MateoHadzimustafic/Voltage-Controlled-Oscillator/images/3D_view.png

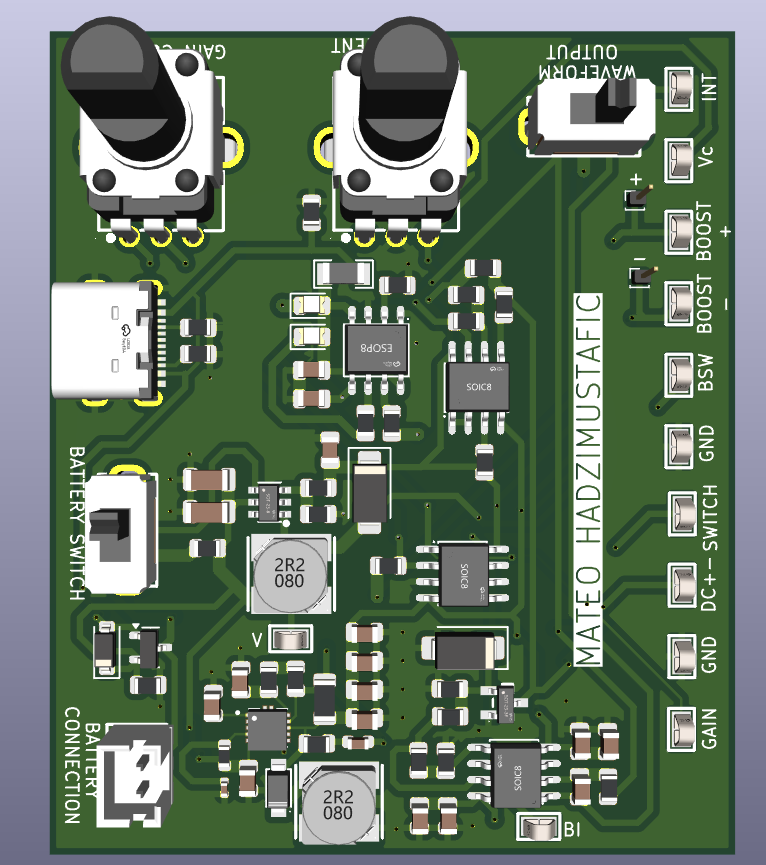
images/3D_view.png
