MateoHadzimustafic/Voltage-Controlled-Oscillator/images/VCO.jpg

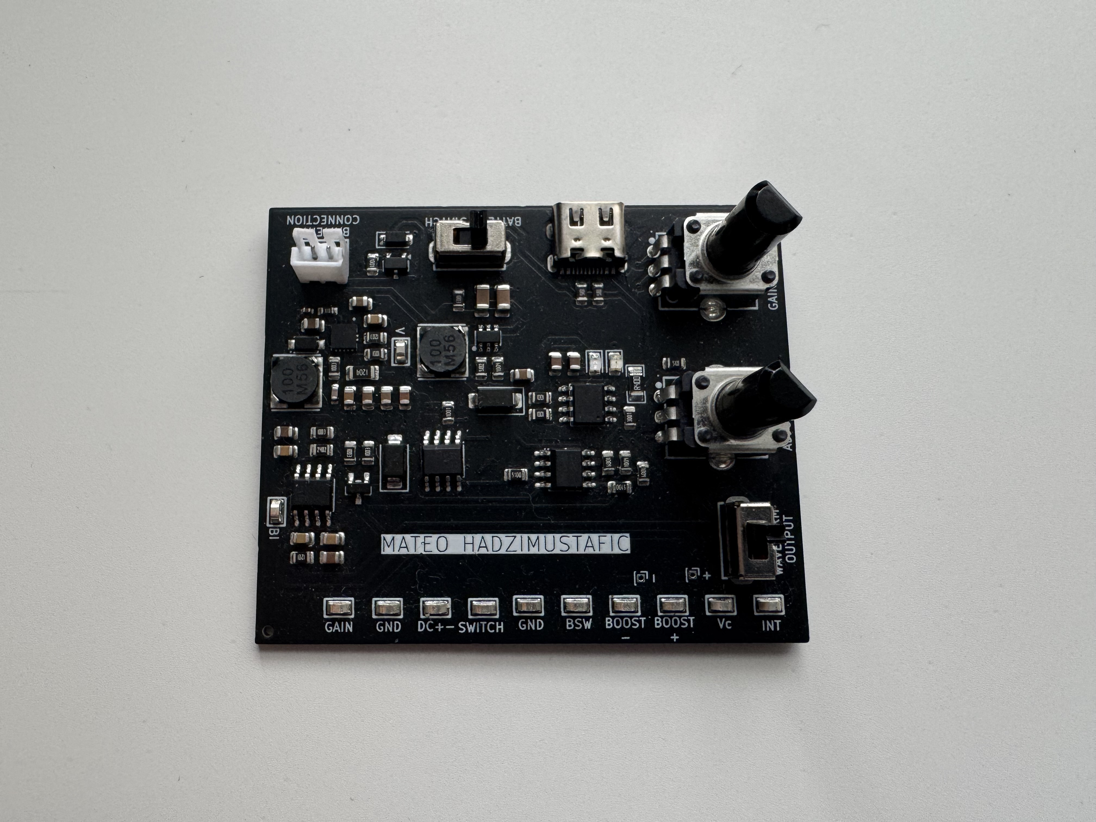
images/VCO.jpg
