MateoHadzimustafic/Voltage-Controlled-Oscillator/README.md

# Voltage-Controlled-Oscillator

## Overview

Designed and built a Voltage-Controlled Oscillator (VCO) capable of generating square and triangle waveforms with adjustable frequency and amplitude using op-amp-based analog circuitry. Integrated USB power management and LiPo battery input for portable or wired operation, including onboard LiPo charging functionality for convenient rechargeable power support.

## Current Status

Completed — Fully designed, built, tested, and validated.

## Features

- Square Wave Generator
- Triangle Wave Generator
- Frequency Control
- Amplitude Control
- Lipo Battery and USB-C Powered
- Lipo Battery Charger

## Repository Structure

- `docs/` — design notes, calculations, and planning
- `hardware/` — schematic, PCB layout, and manufacturing files
- `bom/` — bill of materials and component notes
- `images/` — renders, diagrams, and photos
