MateoHadzimustafic/Voltage-Controlled-Oscillator/images/layout.png

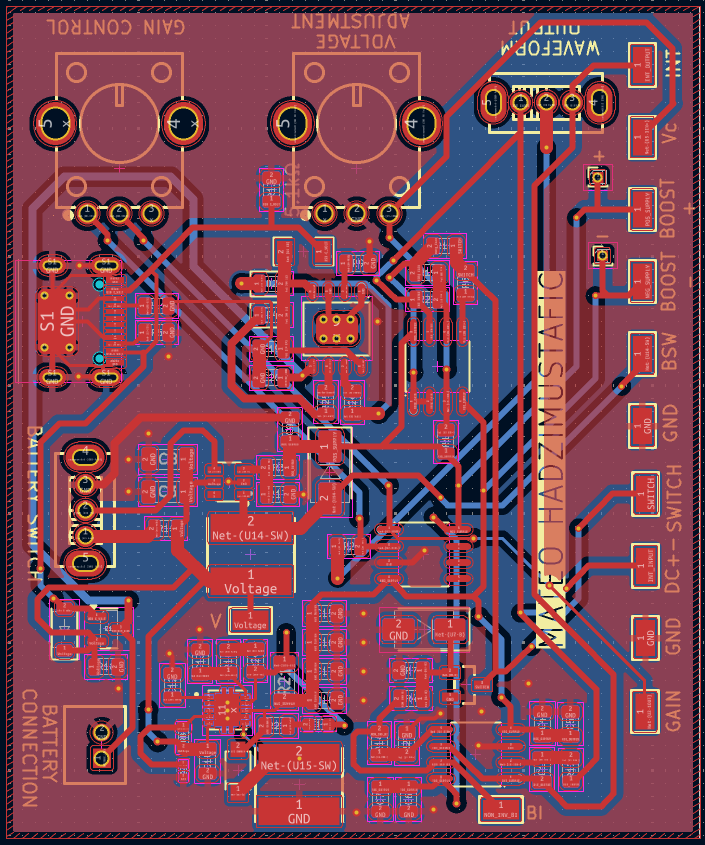
images/layout.png
