MateoHadzimustafic/Voltage-Controlled-Oscillator/images/schematic.png

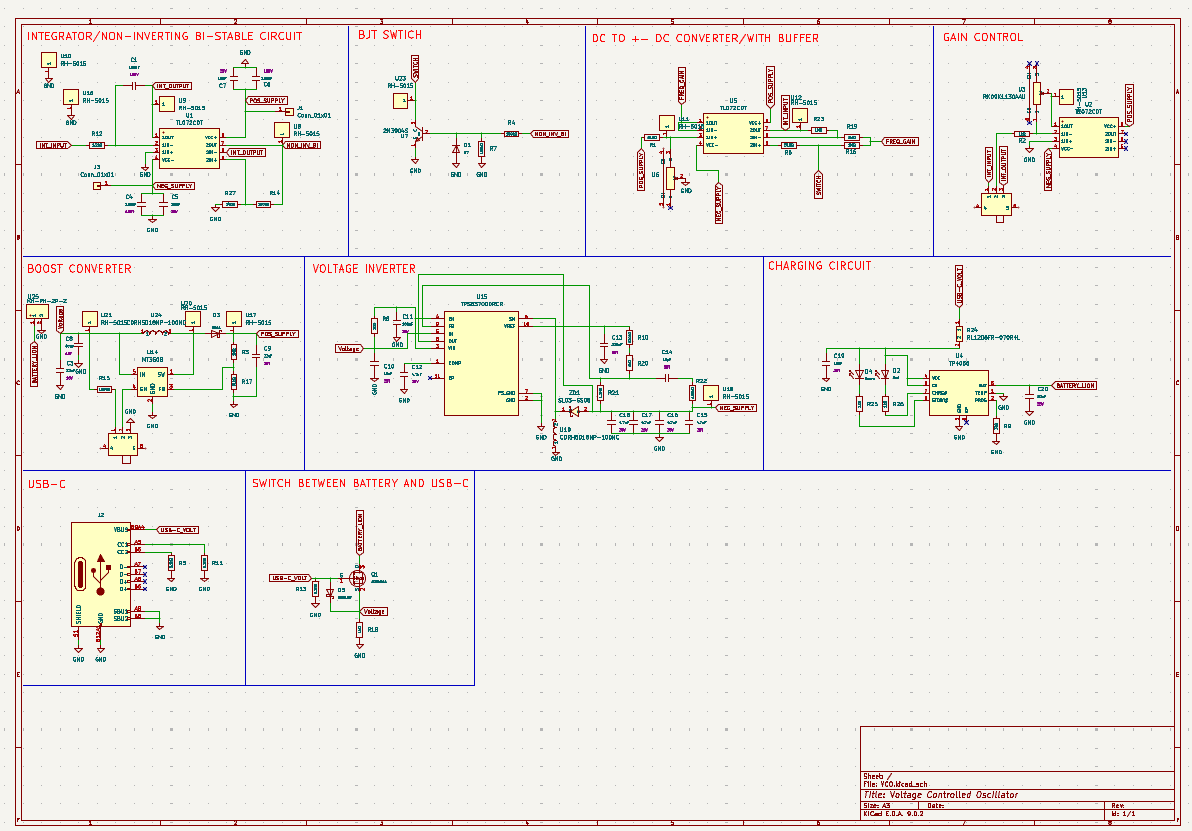
images/schematic.png
