MateoHadzimustafic/Voltage-Controlled-Oscillator/bom/bom.md

# Bill of Materials (BOM)

| Designator | Quantity | Value / Part | Footprint | LCSC Part # |
|---|---|---|---|---|
| C1, C4, C6 | 3 | 100nF | C_0805 | C28233 |
| C10, C19, C20, C5, C7 | 5 | 10uF | C_0805 | C15850 |
| C11 | 1 | 100nF | C_0402 | C1525 |
| C12, C15, C16, C17, C18 | 5 | 4.7uF | C_0805 | C1779 |
| C13 | 1 | 220nF | C_0805 | C5378 |
| C14 | 1 | 1uF | C_0603 | C1634 |
| C3 | 1 | 22uF | C_1206 | C5672 |
| C8 | 1 | 47uF | C_1206 | C96123 |
| C9 | 1 | 22uF | C_0805 | C45783 |
| D1 | 1 | M7 | D_SMA | C95872 |
| D2 | 1 | Red LED | D_0805 | C84256 |
| D3 | 1 | SS14 | D_SMA | C24865 |
| D4 | 1 | Green LED | D_0805 | C2297 |
| D5 | 1 | B5819W | D_SOD-123 | C64885 |
| J1, J3 | 2 | Conn_01x01 | PinHeader_1x01_P2.00mm_Vertical | — |
| J2 | 1 | USB Type-C 16P | TYPE-C-SMD_HX-TYPE-C-16PIN | C2927039 |
| Q1 | 1 | AO3401A | SOT-23 | C15127 |
| R1, R6 | 2 | 510Ω | R_0805 | C17734 |
| R10 | 1 | 120kΩ | R_0805 | C17436 |
| R11, R13, R5 | 3 | 5.1kΩ | R_0805 | C27834 |
| R12 | 1 | 1.2kΩ | R_0805 | C17379 |
| R14, R15, R22, R4, R7 | 5 | 100kΩ | R_0805 | C149504 |
| R16, R19, R23, R3 | 4 | 1MΩ | R_0805 | C17514 |
| R17 | 1 | 510Ω | R_0805 | C17737 |
| R18, R2, R20, R25, R26 | 5 | 1kΩ | R_0805 | C17513 |
| R21 | 1 | 1.2MΩ | R_1206 | C22107 |
| R24 | 1 | RL1206FR-070R4L | R1206 | C32078 |
| R27 | 1 | 24kΩ | R_0805 | C17575 |
| R8 | 1 | 10Ω | R_0603 | C22859 |
| R9 | 1 | 3kΩ | R_0805 | C17661 |
| SW1, SW2 | 2 | SS12D07VG6 | SW-TH_SS12D07VG4 | C393728 |
| U1, U2, U5 | 3 | TL072CDT | SOIC-8_L5.0-W4.0-P1.27-LS6.0-BL | C6961 |
| U10, U11, U12, U13, U16, U17, U18, U20, U21, U23, U8 | 12 | BH-5015 | SMD_BH-5015 | C5199798 |
| U14 | 1 | MT3608 | SOT-23-6 | C84817 |
| U15 | 1 | TPS63700DRCR | VREG_VQFN-10 | C54792 |
| U19, U24 | 2 | CDRH5D18NP-100NC | IND-SMD_L5.7-W5.7 | C113636 |
| U25 | 1 | KH-PH-2P-Z | CONN-TH_LKP-H2 | C2898945 |
| U3, U6 | 2 | RK09K1130AU | RES-TH_RK09K1130AU | C202373 |
| U4 | 1 | TP4056 | ESOP-8 | C16581 |
| U7 | 1 | 2N3904S | SOT-23 | C18536 |
| ZD1 | 1 | SL03-GS08 | SMF_L2.8-W1.8-LS3.7-RD | C490381 |
