MateoHadzimustafic/Voltage-Controlled-Oscillator/(list of files, drawings)

Other design files:
docs/Design1.ms14
