MateoHadzimustafic/Voltage-Controlled-Oscillator/hardware/VCO.kicad_pcb

## KiCad design hardware/VCO.kicad_pcb (2026-04-28)

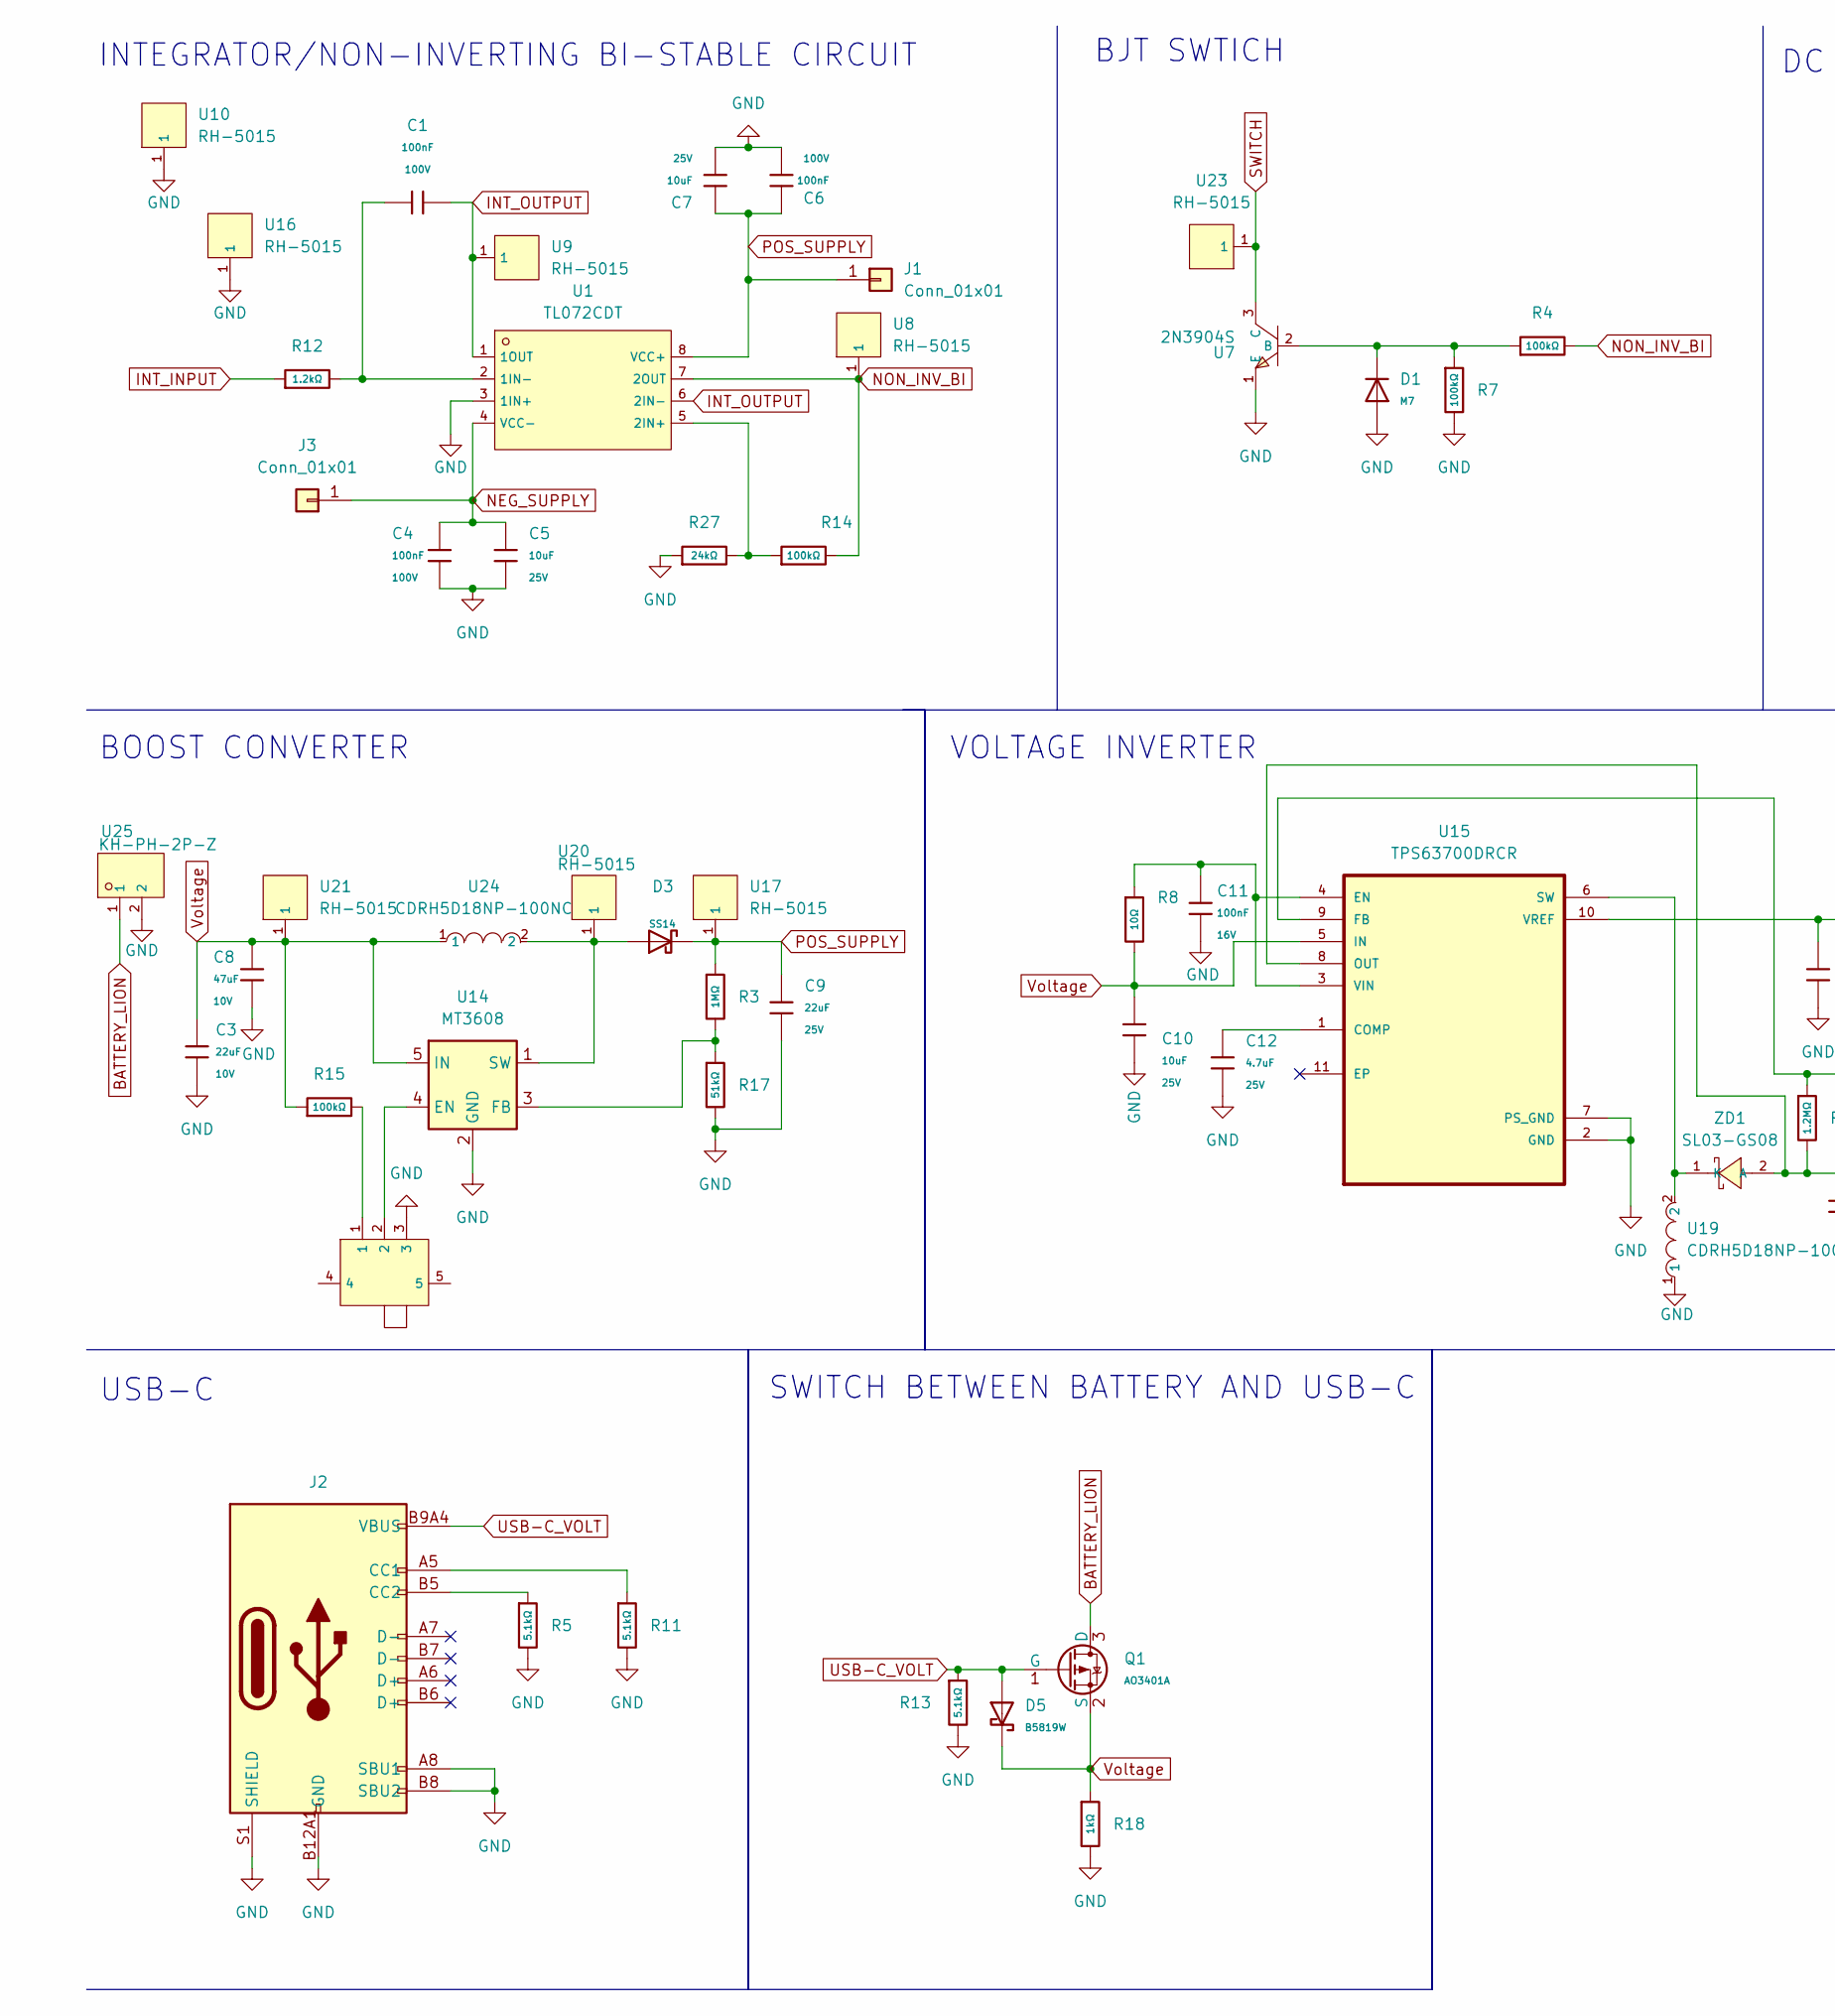
[picture p5: schematic VCO.kicad_sch, Voltage Controlled Oscillator, part in row 1, column 1]

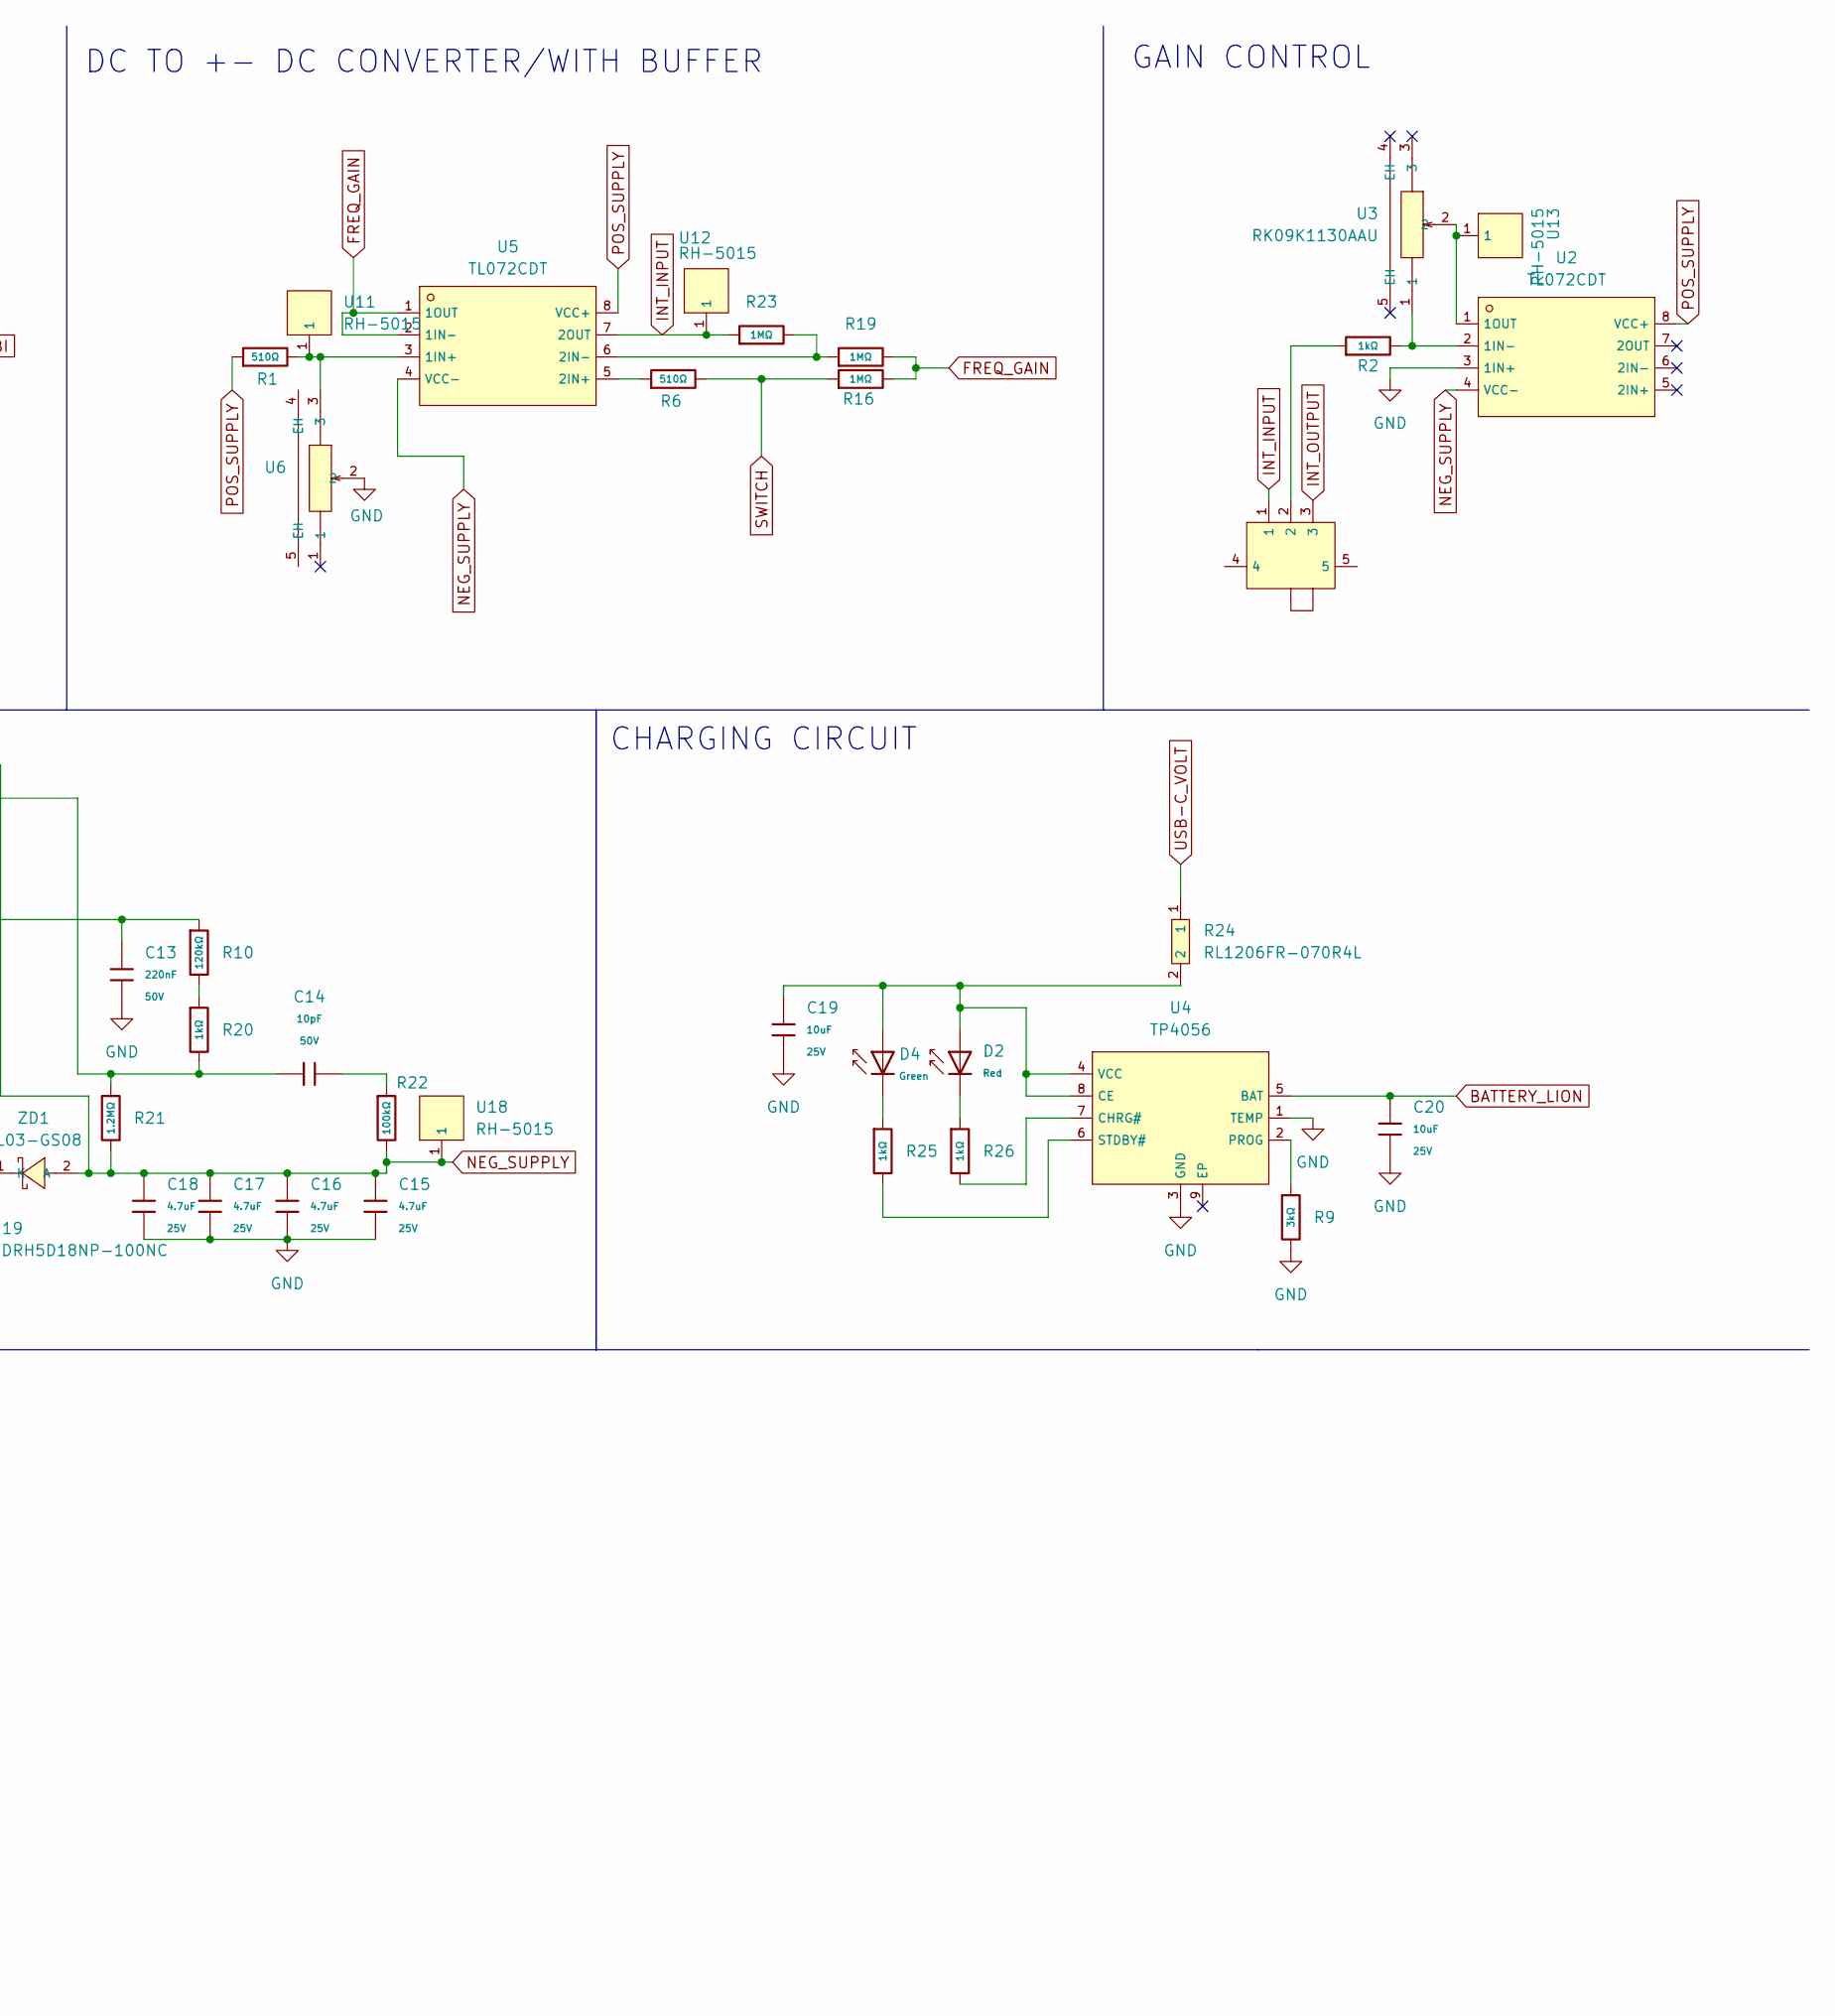
[picture p6: schematic VCO.kicad_sch, Voltage Controlled Oscillator, part in row 1, column 2]

Parts:
C1, C4, C6: 100nF; C_0805; Voltage Rated 100V; Tolerance ±10%; Part CL21B104KCFNNNE; LCSC C28233
C3: 22uF; C_1206; Voltage Rated 10V; Tolerance ±10%; Part CL31A226KPHNNNE; LCSC C5672
C5, C7, C10, C19, C20: 10uF; C_0805; Voltage Rated 25V; Tolerance ±10%; Part CL21A106KAYNNNE; LCSC C15850
C8: 47uF; C_1206; Voltage Rated 10V; Tolerance ±20%; Part CL31A476MPHNNNE; LCSC C96123
C9: 22uF; C_0805; Voltage Rated 25V; Tolerance ±20%; Part CL21A226MAQNNNE; LCSC C45783
C11: 100nF; C_0402; Voltage Rated 16V; Tolerance ±10%; Part CL05B104KO5NNNC; LCSC C1525
C12, C15, C16, C17, C18: 4.7uF; C_0805; Voltage Rated 25V; Tolerance ±10%; Part CL21A475KAQNNNE; LCSC C1779
C13: 220nF; C_0805; Voltage Rated 50V; Tolerance ±10%; Part CL21B224KBFNNNE; LCSC C5378
C14: 10pF; C_0603; Voltage Rated 50V; Tolerance ±5%; Part CL10C100JB8NNNC; LCSC C1634
D1: M7; D_SMA; Forward Voltage (Vf@If) 1.1V@1A; Reverse Voltage (Vr) 1kV; Part M7; LCSC C95872
D2: Red; D_0805; Forward Voltage (VF) 1.6V~2.6V; Part NCD0805R1; LCSC C84256
D3: SS14; D_SMA; Forward Voltage (Vf@If) 0.55V@1.0A; Reverse Voltage (Vr) 40V; Part SS14; LCSC C7420316
D4: Green; D_0805; Part KT-0805G; LCSC C2297
D5: B5819W; D_SOD-123; Forward Voltage (Vf@If) 900mV@3A; Reverse Voltage (Vr) 40V; Part B5819W; LCSC C64885
J1, J3: Conn_01x01; PinHeader_1x01_P1.00mm_Vertical
J2: Connector, USB-TYPE-C-16P; TYPE-C-SMD_HX-TYPE-C-16PIN; LCSC C2927039
Q1: AO3401A; Q_SOT-23; Part AO3401A; LCSC C15127
R1, R6: 510Ω; R_0805; Overload Voltage (Max) 150V; Tolerance ±1%; Part 0805W8F5100T5E; LCSC C17734
R2, R18, R20, R25, R26: 1kΩ; R_0805; Overload Voltage (Max) 150V; Tolerance ±1%; Part 0805W8F1001T5E; LCSC C17513
R3, R16, R19, R23: 1MΩ; R_0805; Overload Voltage (Max) 150V; Tolerance ±1%; Part 0805W8F1004T5E; LCSC C17514
R4, R7, R14, R15, R22: 100kΩ; R_0805; Overload Voltage (Max) 150V; Tolerance ±1%; Part 0805W8F1003T5E; LCSC C149504
R5, R11, R13: 5.1kΩ; R_0805; Overload Voltage (Max) 150V; Tolerance ±1%; Part 0805W8F5101T5E; LCSC C27834
R8: 10Ω; R_0603; Overload Voltage (Max) 75V; Tolerance ±1%; Part 0603WAF100JT5E; LCSC C22859
R9: 3kΩ; R_0805; Overload Voltage (Max) 150V; Tolerance ±1%; Part 0805W8F3001T5E; LCSC C17661
R10: 120kΩ; R_0805; Overload Voltage (Max) 150V; Tolerance ±1%; Part 0805W8F1203T5E; LCSC C17436
R12: 1.2kΩ; R_0805; Overload Voltage (Max) 150V; Tolerance ±1%; Part 0805W8F1201T5E; LCSC C17379
R17: 51kΩ; R_0805; Overload Voltage (Max) 150V; Tolerance ±1%; Part 0805W8F5102T5E; LCSC C17737
R21: 1.2MΩ; R_1206; Overload Voltage (Max) 200V; Tolerance ±1%; Part 1206W4F1204T5E; LCSC C22107
R24: RL1206FR-070R4L; R1206; LCSC C327078
R27: 24kΩ; R_0805; Overload Voltage (Max) 150V; Tolerance ±1%; Part 0805W8F2402T5E; LCSC C17575
SW1, SW2: SS12D07VG6_087; SW-TH_SS12D07VG4; LCSC C2939728
U1, U2, U5: TL072CDT; SOIC-8_L5.0-W4.0-P1.27-LS6.0-BL; Voltage - Input Offset(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 3mV; Part TL072CDT; LCSC C6961
U3, U6: RK09K1130AAU; RES-TH_RK09K1130AAU; LCSC C202373
U4: TP4056; ESOP-8_L4.9-W3.9-P1.27-LS6.0-BL-EP; Part TP4056-42-ESOP8; LCSC C16581
U7: 2N3904S; SOT-23-3_L2.9-W1.3-P1.90-LS2.4-TR; LCSC C18536
U8, U9, U10, U11, U12, U13, U16, U17, U18, U20, U21, U23: RH-5015; SMD_RH-5015; LCSC C5199798
U14: MT3608; SOT-23-6_L2.9-W1.6-P0.95-LS2.8-BL; LCSC C84817
U15: TPS63700DRCR; VREG_V62_16624-01YE; LCSC C54792
U19, U24: CDRH5D18NP-100NC; IND-SMD_L5.7-W5.7_CDRH5D18NP; LCSC C113636
U25: KH-PH-2P-Z; CONN-TH_2P-P2.00_KINGHELM_KH-PH-2P-Z; LCSC C2898945
ZD1: SL03-GS08; SMF_L2.8-W1.8-LS3.7-RD; LCSC C490381

Connections:
BATTERY_LION: C20.1, Q1.3 (D), U4.5 (BAT), U25.1
FREQ_GAIN: R16.2, R19.2, U5.1 (1OUT), U5.2 (1IN-)
GND: C3.2, C4.2, C5.2, C6.2, C7.2, C8.2, C9.2, C10.2, C11.2, C12.2, C13.2, C15.2, C16.2, C17.2, C18.2, C19.2, C20.2, D1.2, J2.A8 (SBU1), J2.A12B1 (GND), J2.B8 (SBU2), J2.B12A1 (GND), J2.S1 (SHIELD), R5.2, R7.2, R9.2, R11.2, R13.2, R17.2, R18.2, R27.1, SW1.3, U1.3 (1IN+), U2.3 (1IN+), U4.1 (TEMP), U4.3 (GND), U6.2, U7.1 (E), U10.1, U14.2 (GND), U15.2 (GND), U15.7 (PS_GND), U16.1, U19.1, U25.2
INT_INPUT: R12.1, R23.1, SW2.1, U5.7 (2OUT), U12.1
INT_OUTPUT: C1.2, SW2.3, U1.1 (1OUT), U1.6 (2IN-), U9.1
NEG_SUPPLY: C4.1, C5.1, C15.1, C16.1, C17.1, C18.1, J3.1, R21.2, R22.2, U1.4 (VCC-), U2.4 (VCC-), U5.4 (VCC-), U15.8 (OUT), U18.1, ZD1.2 (A)
NON_INV_BI: R4.2, R14.2, U1.7 (2OUT), U8.1
unnamed: C14.2, R22.1
unnamed: D2.1, R26.1
unnamed: D4.1, R25.1
unnamed: J2.A5 (CC1), R11.1
unnamed: J2.B5 (CC2), R5.1
unnamed: R2.1, SW2.2
unnamed: R10.2, R20.1
unnamed: R15.2, SW1.1
unnamed: C1.1, R12.2, U1.2 (1IN-)
unnamed: R14.1, R27.2, U1.5 (2IN+)
unnamed: R2.2, U2.2 (1IN-), U3.1
unnamed: U2.1 (1OUT), U3.2, U13.1
unnamed: C19.1, D2.2, D4.2, R24.2, U4.4 (VCC), U4.8 (CE)
unnamed: R26.2, U4.7 (CHRG#)
unnamed: R9.1, U4.2 (PROG)
unnamed: R25.2, U4.6 (STDBY#)
unnamed: R1.2, U5.3 (1IN+), U6.3, U11.1
unnamed: R6.1, U5.5 (2IN+)
unnamed: R19.1, R23.2, U5.6 (2IN-)
unnamed: D1.1, R4.1, R7.1, U7.2 (B)
unnamed: SW1.2, U14.4 (EN)
unnamed: R3.2, R17.1, U14.3 (FB)
unnamed: D3.2, U14.1 (SW), U20.1, U24.2
unnamed: C12.1, U15.1 (COMP)
unnamed: C11.1, R8.1, U15.3 (VIN), U15.4 (EN)
unnamed: C14.1, R20.2, R21.1, U15.9 (FB)
unnamed: U15.6 (SW), U19.2, ZD1.1 (K)
unnamed: C13.1, R10.1, U15.10 (VREF)
POS_SUPPLY: C6.1, C7.1, C9.1, D3.1, J1.1, R1.1, R3.1, U1.8 (VCC+), U2.8 (VCC+), U5.8 (VCC+), U17.1
SWITCH: R6.2, R16.1, U7.3 (C), U23.1
USB-C_VOLT: D5.2, J2.A9B4 (VBUS), J2.B9A4 (VBUS), Q1.1 (G), R13.1, R24.1
Voltage: C3.1, C8.1, C10.1, D5.1, Q1.2 (S), R8.2, R15.1, R18.1, U14.5 (IN), U15.5 (IN), U21.1, U24.1

Notes on the sheet:
BJT SWTICH
GAIN CONTROL
VOLTAGE INVERTER
DC TO +- DC CONVERTER/WITH BUFFER
CHARGING CIRCUIT
SWITCH BETWEEN BATTERY AND USB-C
USB-C
INTEGRATOR/NON-INVERTING BI-STABLE CIRCUIT
BOOST CONVERTER

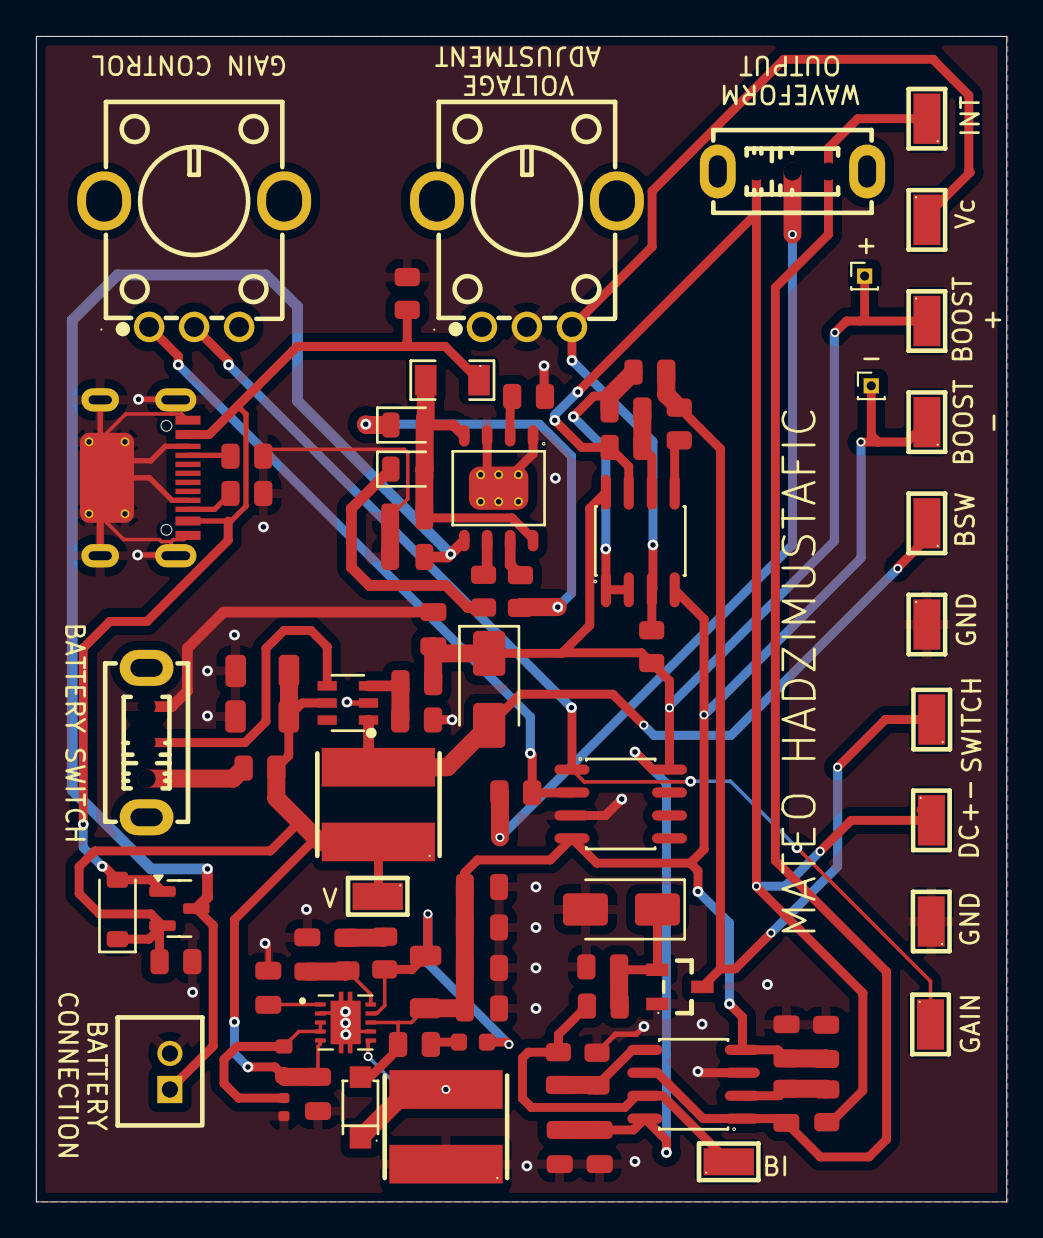
[picture p7: board VCO.kicad_pcb from above]

Board: 2 copper layers, 53.9 x 64.8 mm, 82 parts (0 on the bottom side), 39 nets.
