MateoHadzimustafic/Voltage-Controlled-Oscillator/(commit log)

2026-04-28 Create schematic
2026-04-28 Create bom
